alaminahmed-web/silicone-casting-devices/dual-axis-rotocaster/cad/control-box/lid_preview.png

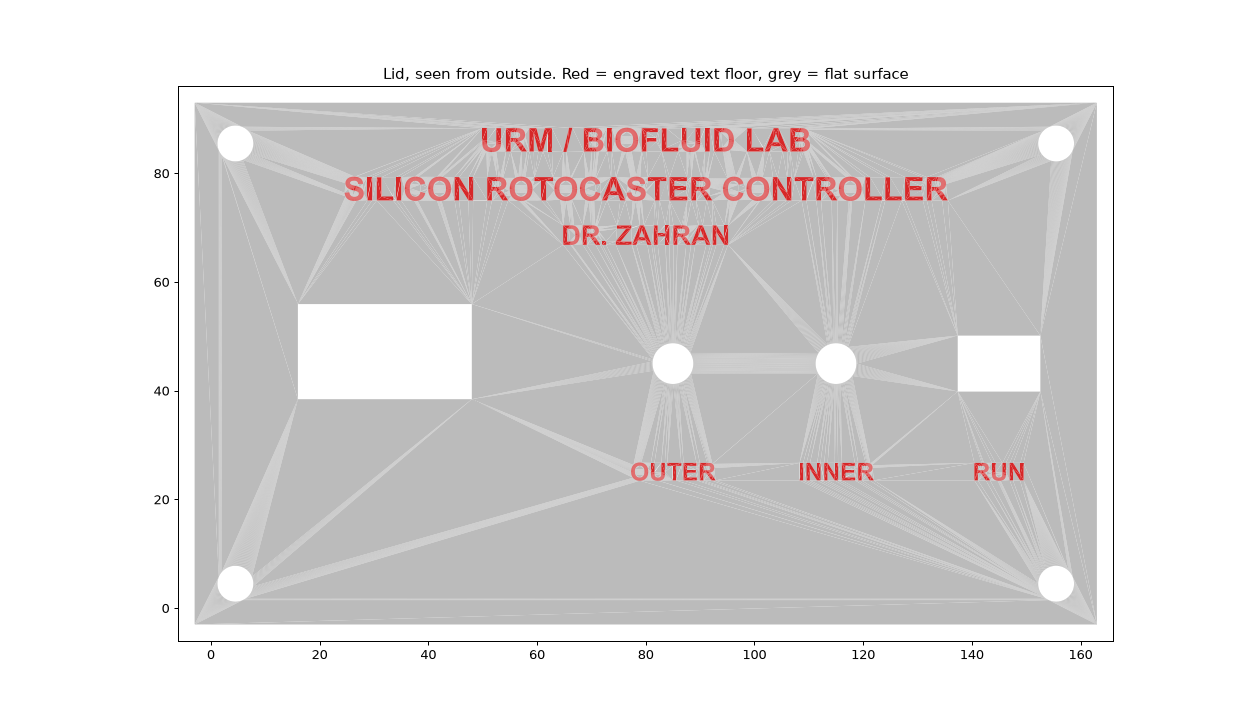
dual-axis-rotocaster/cad/control-box/lid_preview.png
