alaminahmed-web/silicone-casting-devices/dual-axis-rotocaster/photos/rotocaster_front_3.jpg

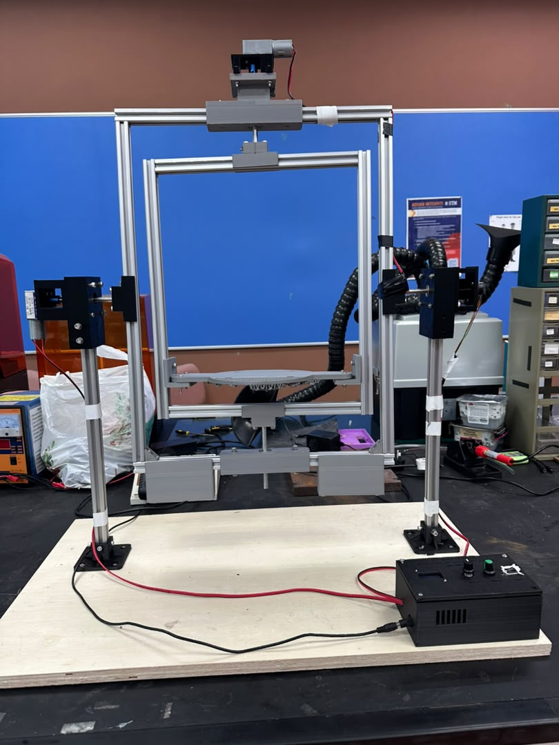
dual-axis-rotocaster/photos/rotocaster_front_3.jpg
