alaminahmed-web/silicone-casting-devices/dual-axis-rotocaster/cad/control-box/assembly.step

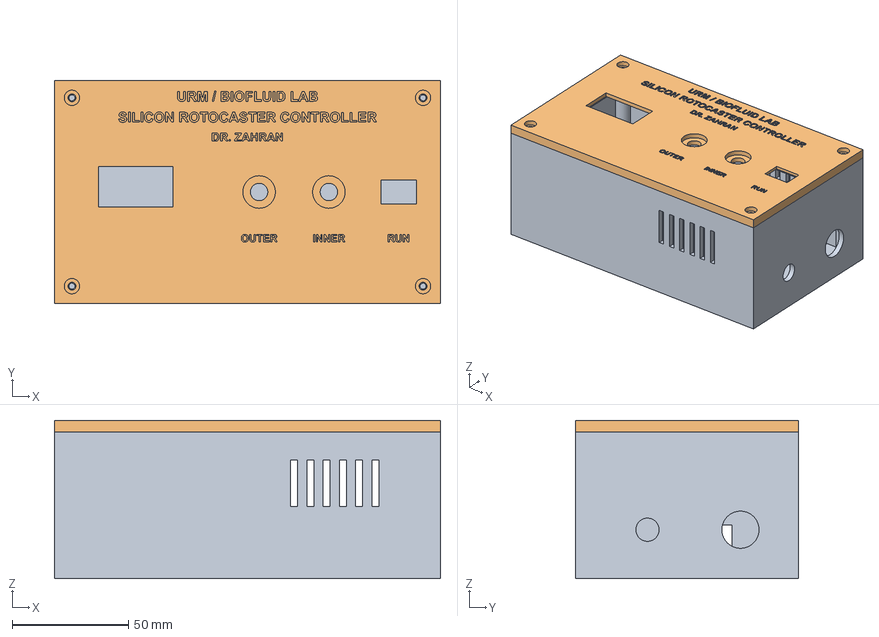
[picture p42: CAD file, 2026-11-06]
dual-axis-rotocaster/cad/control-box/assembly.step
166.0 x 96.0 x 68.0 mm
lid
