alaminahmed-web/silicone-casting-devices/dual-axis-rotocaster/cad/control-box/lid_print.stl

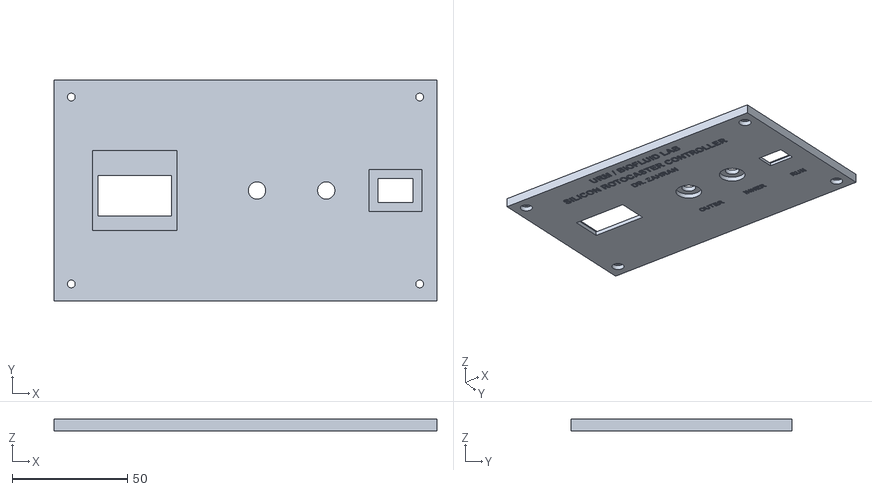
[picture p43: CAD file, 2026-11-06]
dual-axis-rotocaster/cad/control-box/lid_print.stl
166.0 x 96.0 x 5.00
