alaminahmed-web/silicone-casting-devices/dual-axis-rotocaster/cad/printed-parts/02_shaft_gripper_D-flat_x4.stl

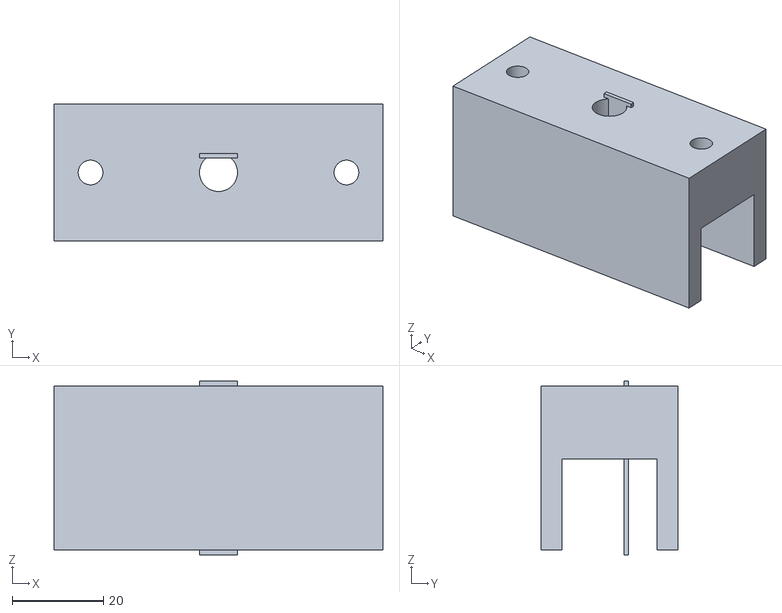
[picture p44: CAD file, 2026-11-06]
dual-axis-rotocaster/cad/printed-parts/02_shaft_gripper_D-flat_x4.stl
72.0 x 30.0 x 38.0
