alaminahmed-web/silicone-casting-devices/single-axis-roller/cad/MOTOR_SEAT_79x59_H56.stl

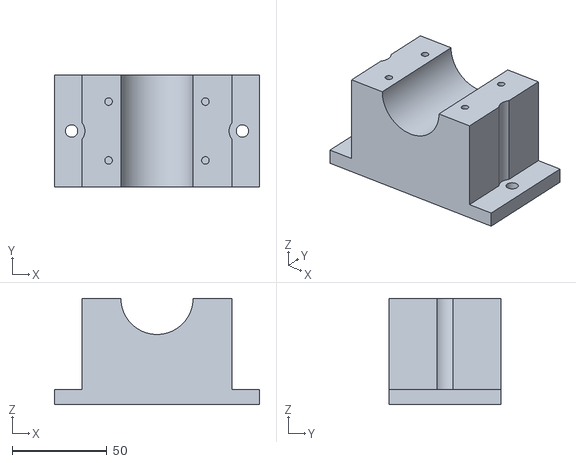
[picture p45: CAD file, 2026-11-06]
single-axis-roller/cad/MOTOR_SEAT_79x59_H56.stl
108.0 x 59.0 x 56.0
