alaminahmed-web/silicone-casting-devices/dual-axis-rotocaster/cad/control-box/body.stl

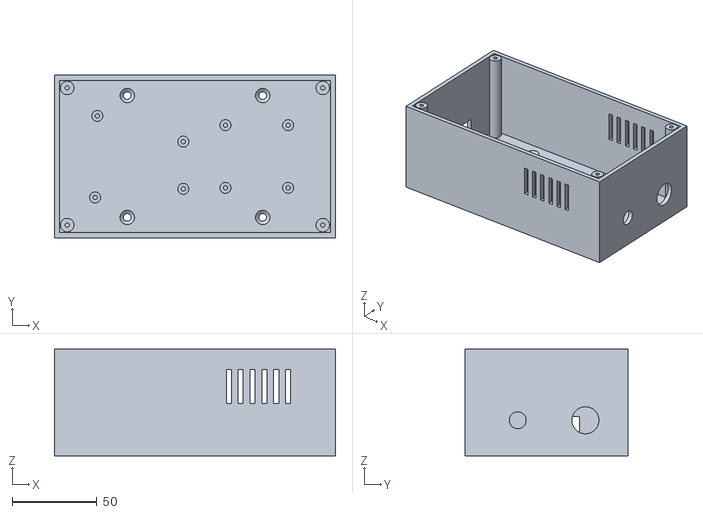
[picture p46: CAD file, 2026-11-06]
dual-axis-rotocaster/cad/control-box/body.stl
166.0 x 96.0 x 63.0
