alaminahmed-web/silicone-casting-devices/dual-axis-rotocaster/cad/printed-parts/14_motor2_standoff_x1.stl

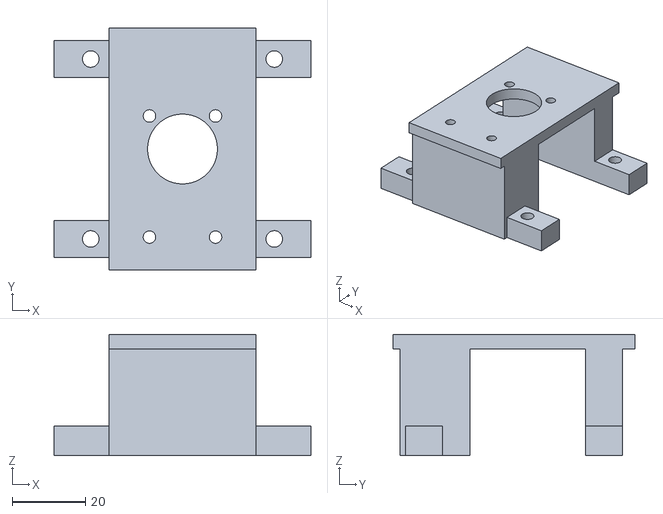
[picture p47: CAD file, 2026-11-06]
dual-axis-rotocaster/cad/printed-parts/14_motor2_standoff_x1.stl
70.0 x 66.0 x 33.0
