alaminahmed-web/silicone-casting-devices/single-axis-roller/cad/hub_disc_D47_T10.stl

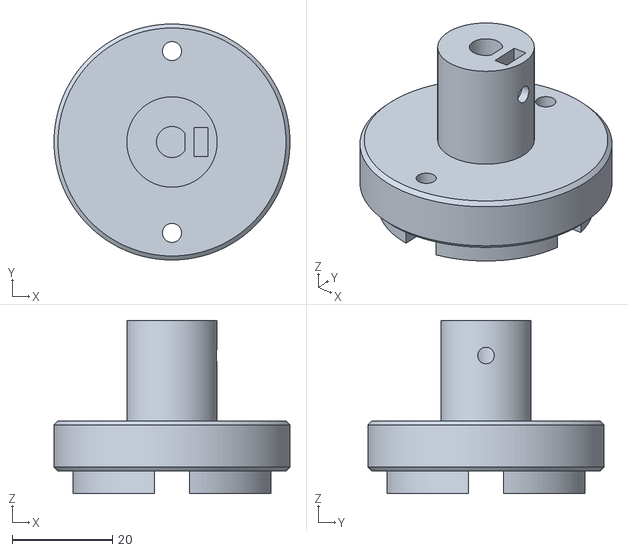
[picture p48: CAD file, 2026-11-06]
single-axis-roller/cad/hub_disc_D47_T10.stl
47.0 x 47.0 x 34.5
