alaminahmed-web/silicone-casting-devices/dual-axis-rotocaster/cad/printed-parts/05_motor1_spacer_x1.stl

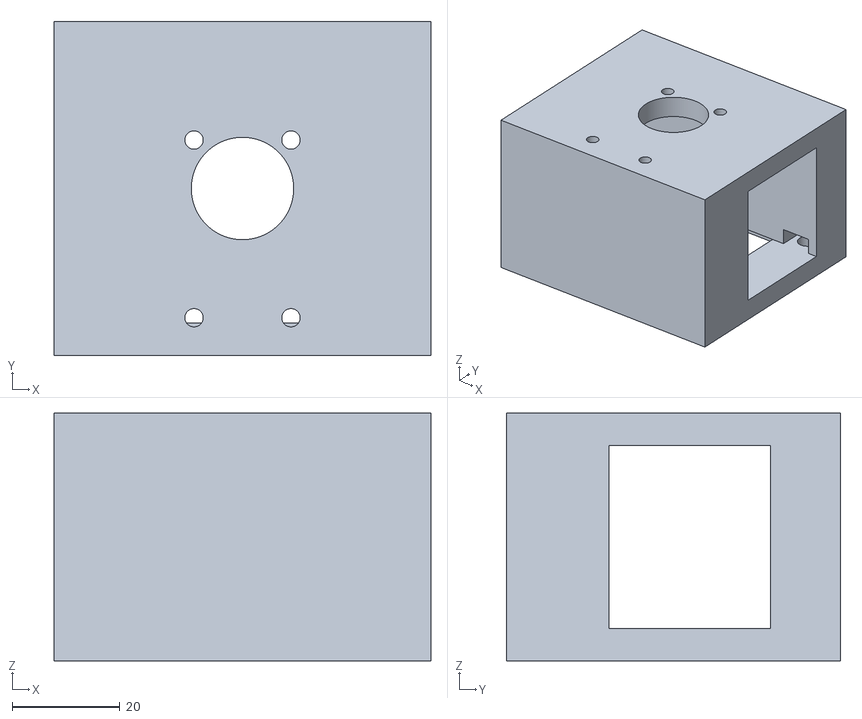
[picture p49: CAD file, 2026-11-06]
dual-axis-rotocaster/cad/printed-parts/05_motor1_spacer_x1.stl
70.0 x 62.0 x 46.0
