alaminahmed-web/silicone-casting-devices/dual-axis-rotocaster/cad/printed-parts/12b_slipring_coupler_x1.stl

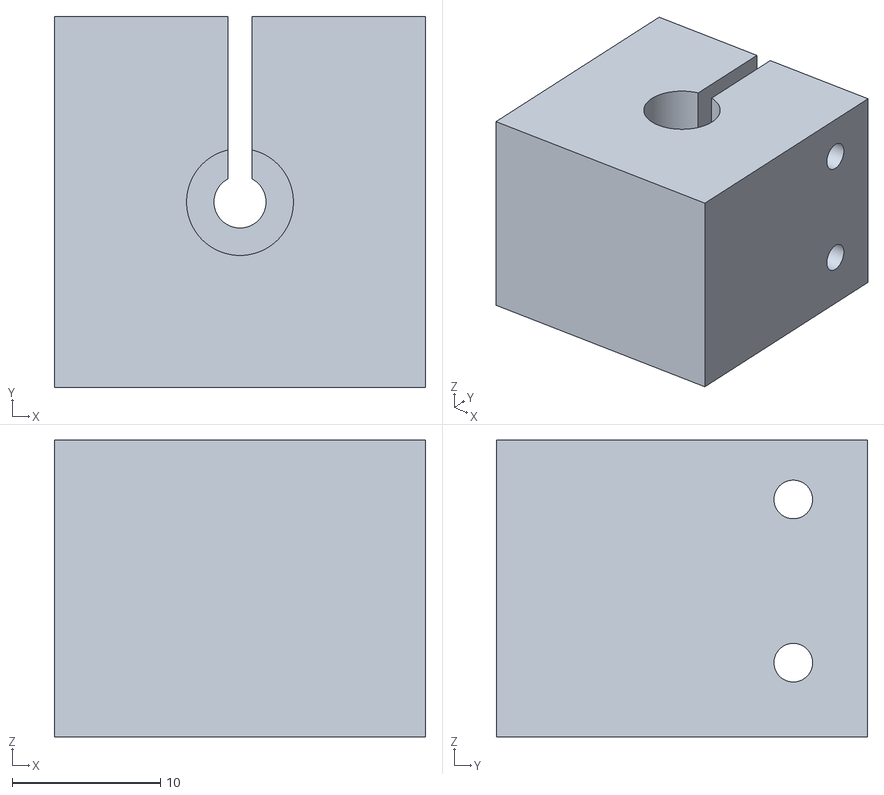
[picture p50: CAD file, 2026-11-06]
dual-axis-rotocaster/cad/printed-parts/12b_slipring_coupler_x1.stl
25.0 x 25.0 x 20.0
