alaminahmed-web/silicone-casting-devices/dual-axis-rotocaster/cad/printed-parts/03_outer_frame_top_bridge_motor2_x1.stl

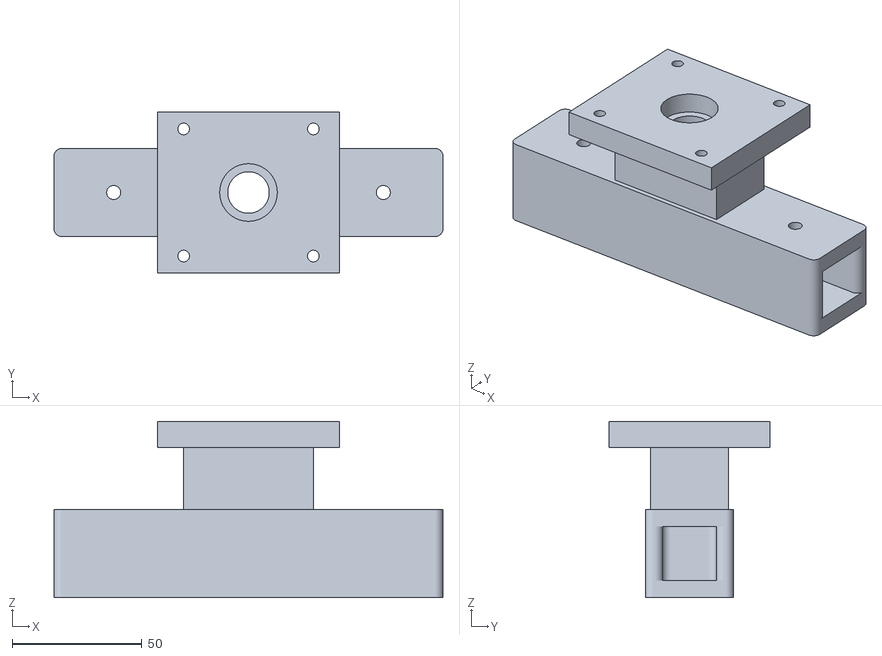
[picture p51: CAD file, 2026-11-06]
dual-axis-rotocaster/cad/printed-parts/03_outer_frame_top_bridge_motor2_x1.stl
150.0 x 62.0 x 68.0
