alaminahmed-web/silicone-casting-devices/dual-axis-rotocaster/cad/printed-parts/08_mould_plate_REFERENCE_do_not_print.stl

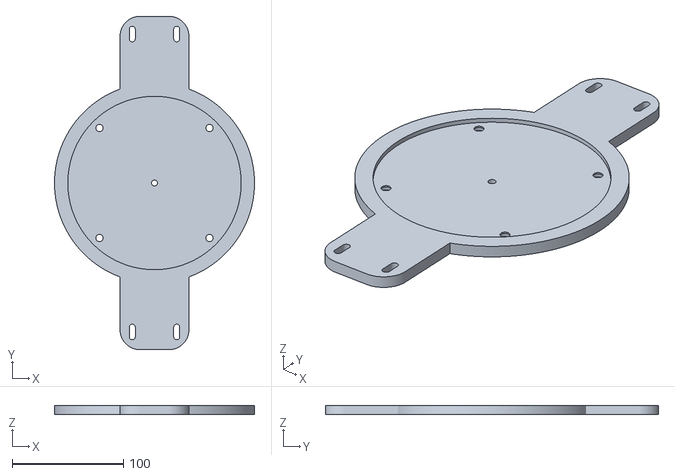
[picture p52: CAD file, 2026-11-06]
dual-axis-rotocaster/cad/printed-parts/08_mould_plate_REFERENCE_do_not_print.stl
180.0 x 300.0 x 8.00
