alaminahmed-web/silicone-casting-devices/dual-axis-rotocaster/cad/printed-parts/00_bearing_fit_gauge_x1.stl

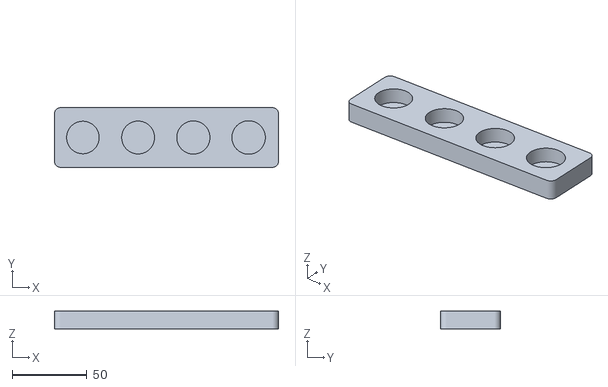
[picture p53: CAD file, 2026-11-06]
dual-axis-rotocaster/cad/printed-parts/00_bearing_fit_gauge_x1.stl
150.0 x 40.0 x 12.0
