alaminahmed-web/silicone-casting-devices/dual-axis-rotocaster/cad/printed-parts/13_slipring_bracket_x1.stl

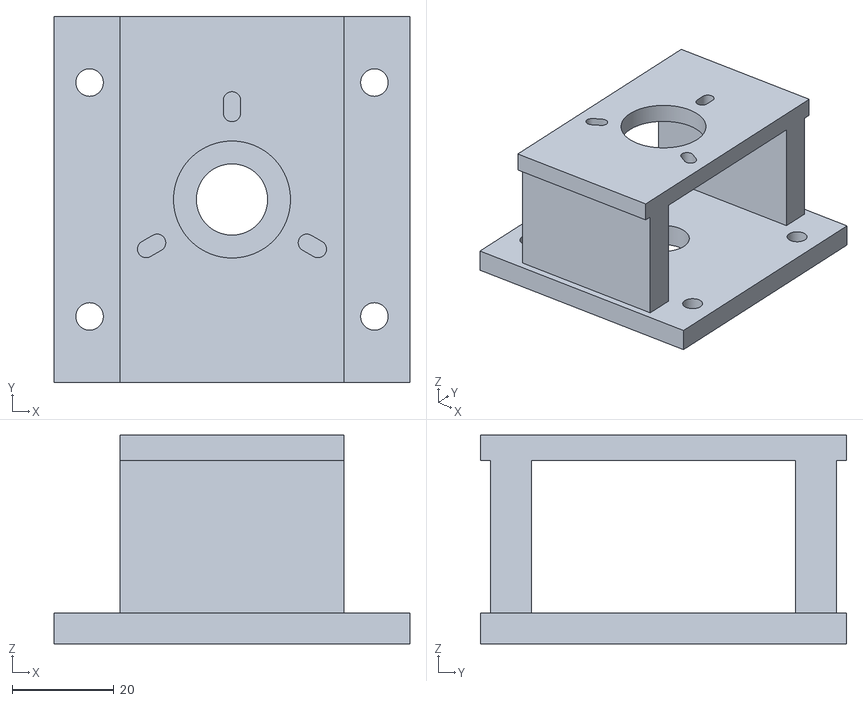
[picture p54: CAD file, 2026-11-06]
dual-axis-rotocaster/cad/printed-parts/13_slipring_bracket_x1.stl
70.0 x 72.0 x 41.0
