alaminahmed-web/silicone-casting-devices/dual-axis-rotocaster/cad/printed-parts/07b_counterweight_cover_x2.stl

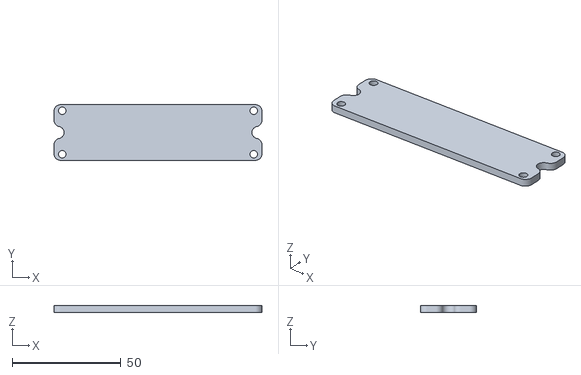
[picture p55: CAD file, 2026-11-06]
dual-axis-rotocaster/cad/printed-parts/07b_counterweight_cover_x2.stl
95.6 x 25.6 x 3.00
