alaminahmed-web/silicone-casting-devices/dual-axis-rotocaster/cad/printed-parts/06_inner_frame_plate_shelf_x2.stl

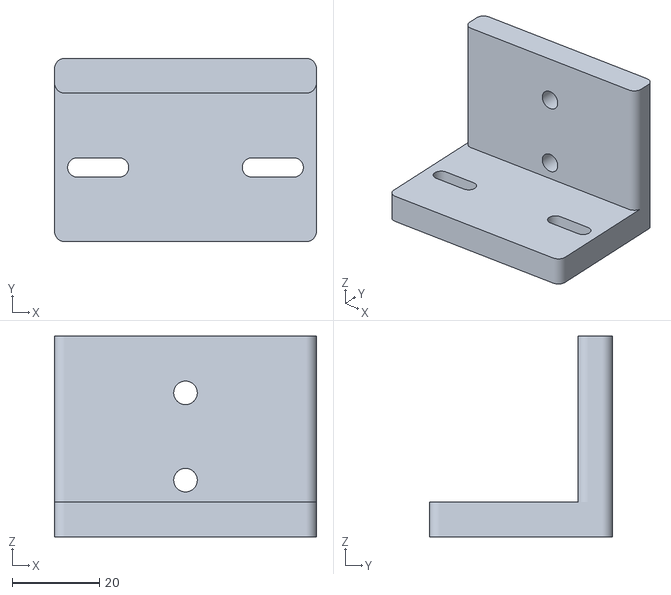
[picture p56: CAD file, 2026-11-06]
dual-axis-rotocaster/cad/printed-parts/06_inner_frame_plate_shelf_x2.stl
60.0 x 42.0 x 46.0
