alaminahmed-web/silicone-casting-devices/dual-axis-rotocaster/cad/printed-parts/15_base_post_socket_v3_x2.stl

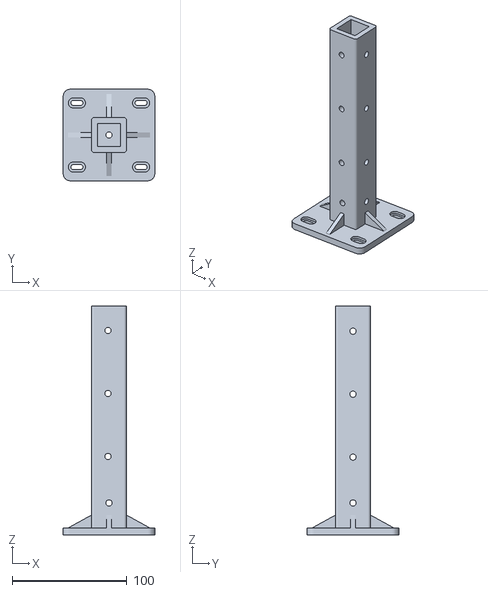
[picture p57: CAD file, 2026-11-06]
dual-axis-rotocaster/cad/printed-parts/15_base_post_socket_v3_x2.stl
80.0 x 80.0 x 200.0
