alaminahmed-web/silicone-casting-devices/dual-axis-rotocaster/cad/printed-parts/07_counterweight_x2.stl

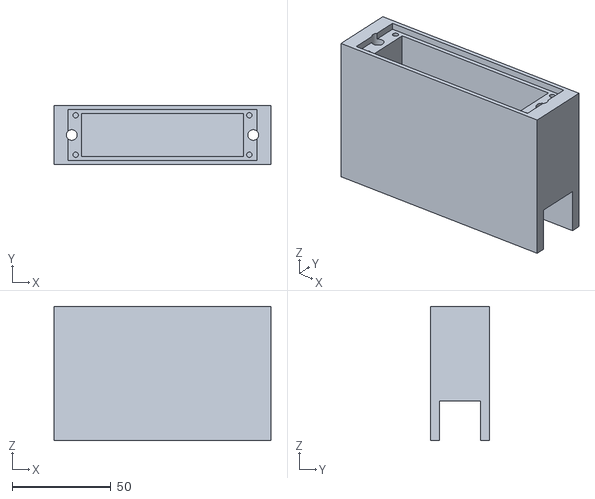
[picture p59: CAD file, 2026-11-06]
dual-axis-rotocaster/cad/printed-parts/07_counterweight_x2.stl
110.0 x 30.0 x 68.0
