alaminahmed-web/silicone-casting-devices/dual-axis-rotocaster/cad/printed-parts/04_outer_frame_bottom_bridge_x1.stl

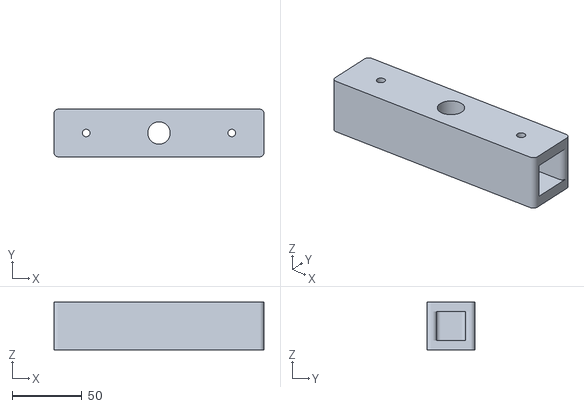
[picture p60: CAD file, 2026-11-06]
dual-axis-rotocaster/cad/printed-parts/04_outer_frame_bottom_bridge_x1.stl
150.0 x 34.0 x 34.0
