alaminahmed-web/silicone-casting-devices/dual-axis-rotocaster/cad/printed-parts/01_tower_post_x2.stl

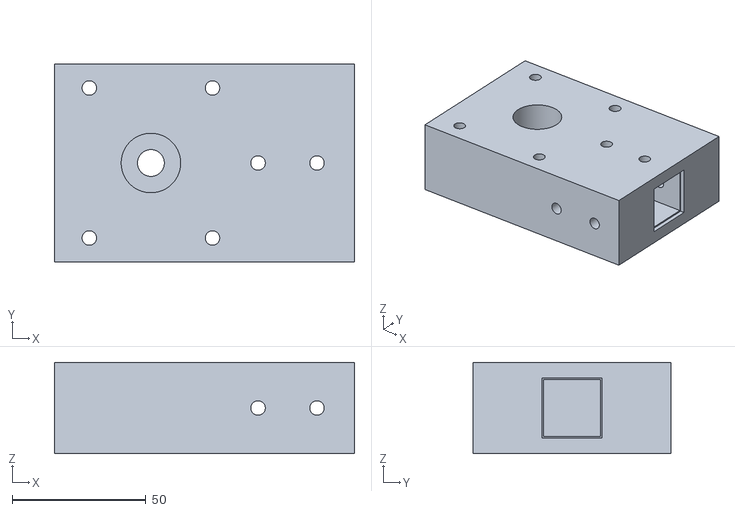
[picture p61: CAD file, 2026-11-06]
dual-axis-rotocaster/cad/printed-parts/01_tower_post_x2.stl
112.0 x 74.0 x 34.0
