alaminahmed-web/silicone-casting-devices/dual-axis-rotocaster/cad/printed-parts/02b_shaft_gripper_clamping_x4.stl

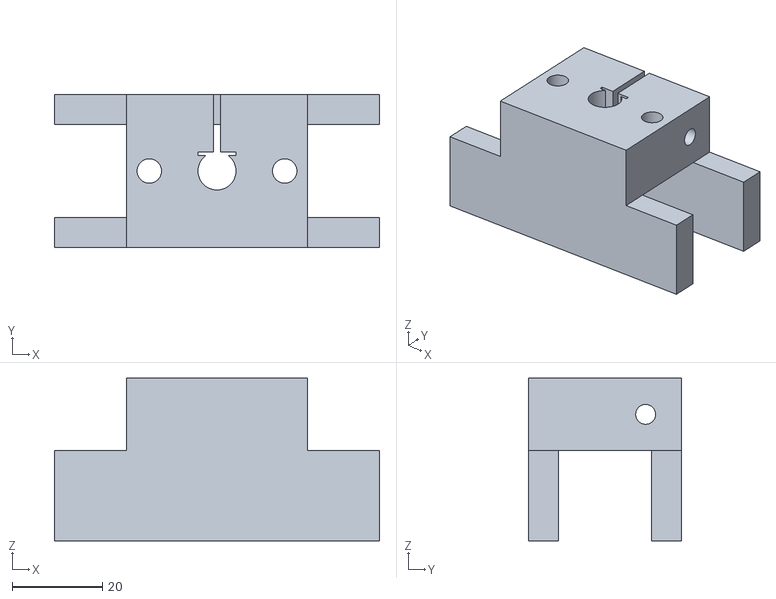
[picture p62: CAD file, 2026-11-06]
dual-axis-rotocaster/cad/printed-parts/02b_shaft_gripper_clamping_x4.stl
72.0 x 34.0 x 36.0
